Lenna-Robotics-Research-Lab/Lenna-SBR/README.md

# Lenna-SBR
The mechatronics course capstone project for Spring 2022 conducted in Iran University of Science and Technology. 
contributers : Erfan Riazati , Arian Hajizadeh , Sorin Yousefnia
